Jonsmith9847/ROCO-224-BFA/MEDIA/first_design_1.PNG

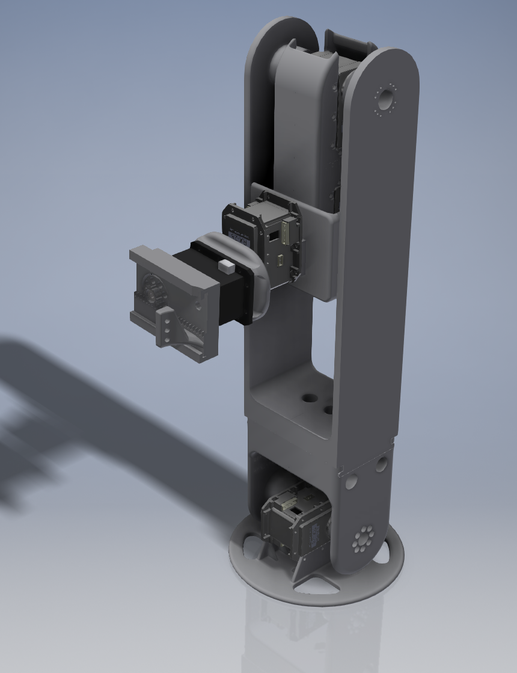
MEDIA/first_design_1.PNG
