Jonsmith9847/ROCO-224-BFA/MEDIA/IMG_20180423_183604.jpg

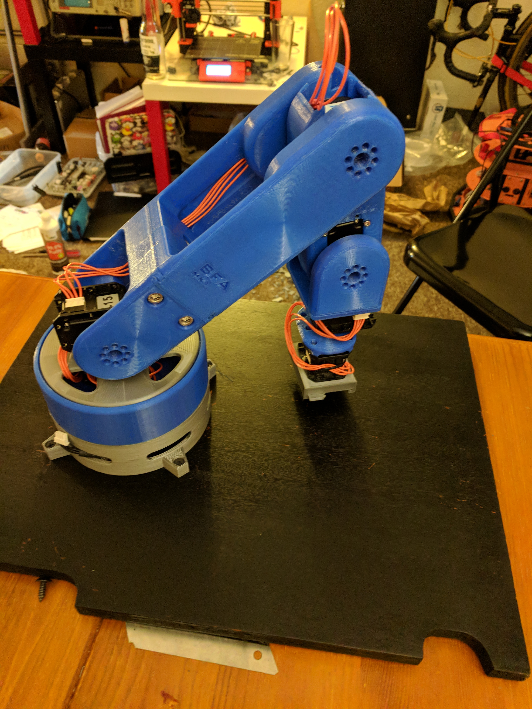
MEDIA/IMG_20180423_183604.jpg
