Jonsmith9847/ROCO-224-BFA/README.md

# ROCO-224 Robotic arm

## Group BFA - Teleoperated Space Manipulator
