Jonsmith9847/ROCO-224-BFA/CAD/ENS_SERVO-RX-28.pdf

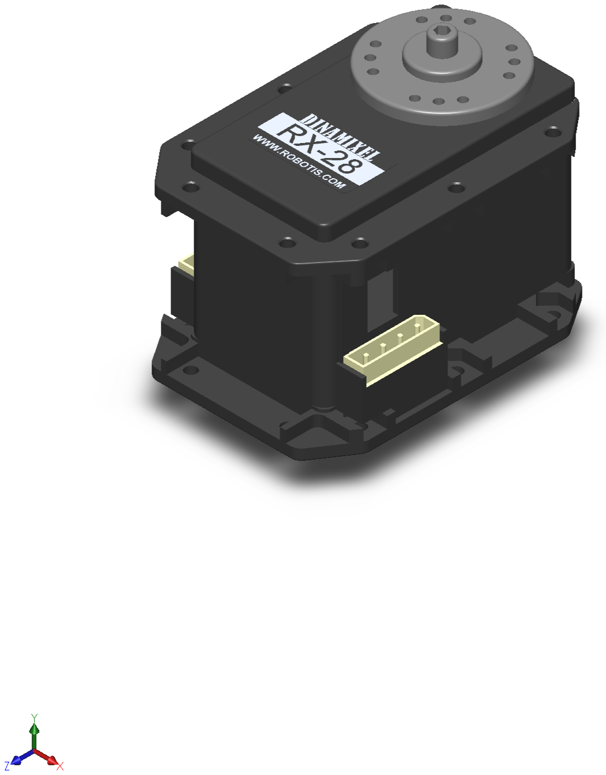
[picture p26: page 1]
