Jonsmith9847/ROCO-224-BFA/MEDIA/arm_assy_v2_render1.png

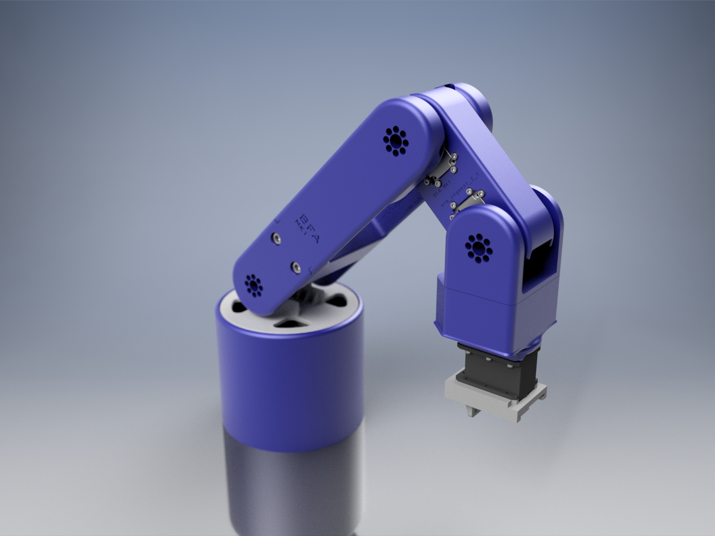
MEDIA/arm_assy_v2_render1.png
