Jonsmith9847/ROCO-224-BFA/MEDIA/arm_assy_v3_render1.png

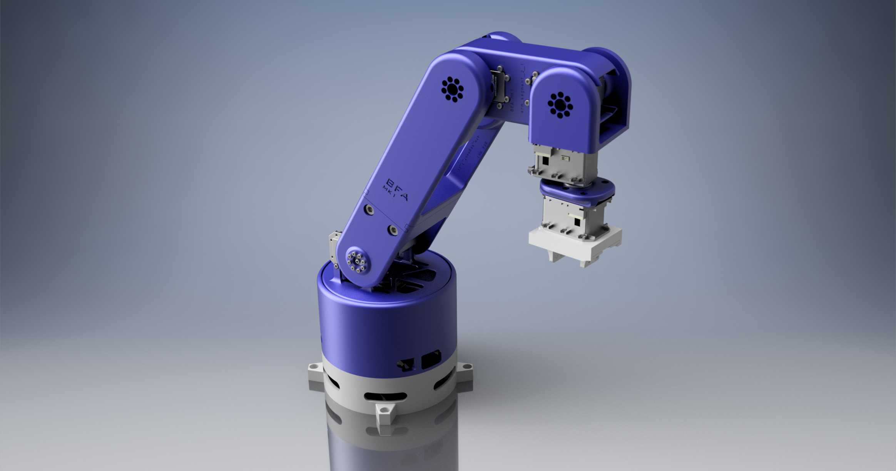
MEDIA/arm_assy_v3_render1.png
