Jonsmith9847/ROCO-224-BFA/MEDIA/base_turret_v2.png

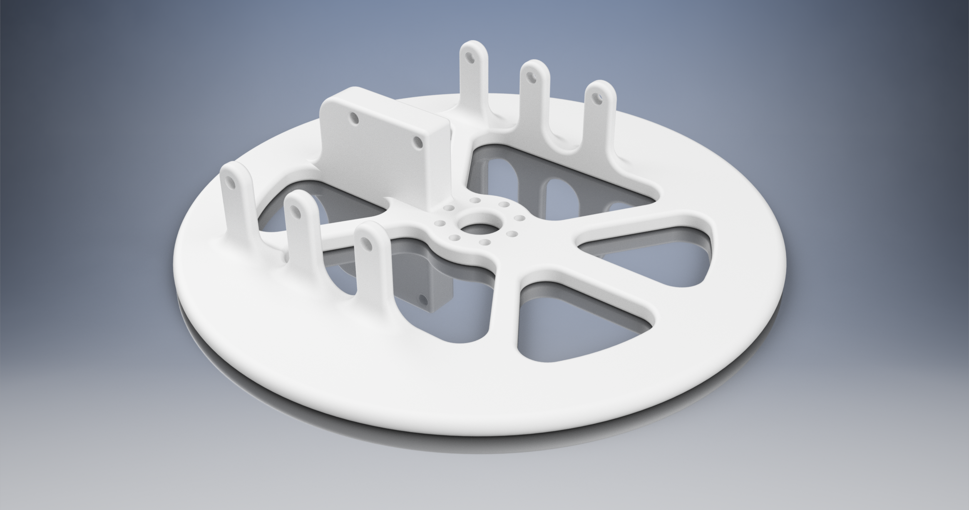
MEDIA/base_turret_v2.png
