Jonsmith9847/ROCO-224-BFA/MEDIA/IMG-20180423-WA0009.jpg

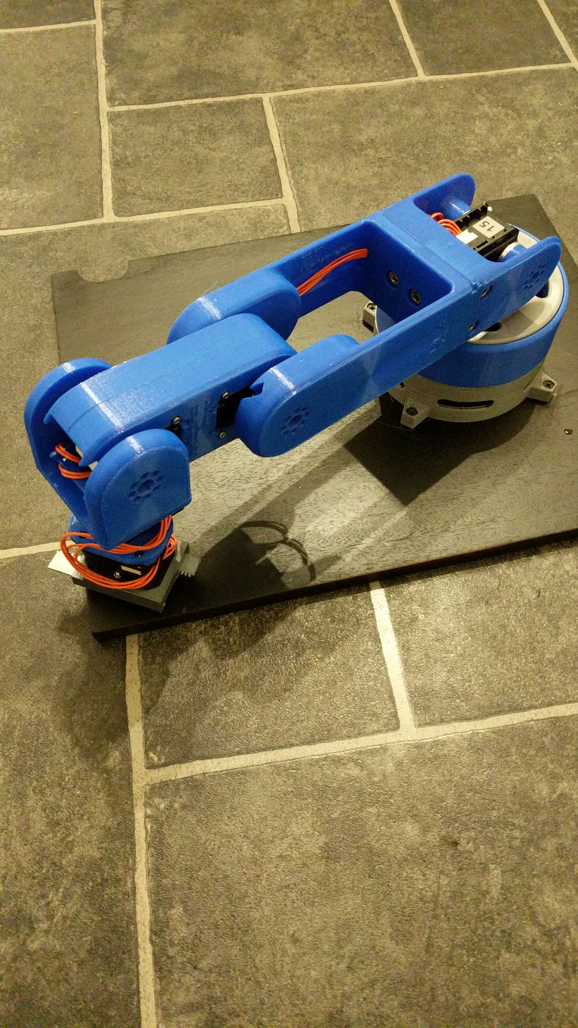
MEDIA/IMG-20180423-WA0009.jpg
