Jonsmith9847/ROCO-224-BFA/MEDIA/IMG_20180423_155627.jpg

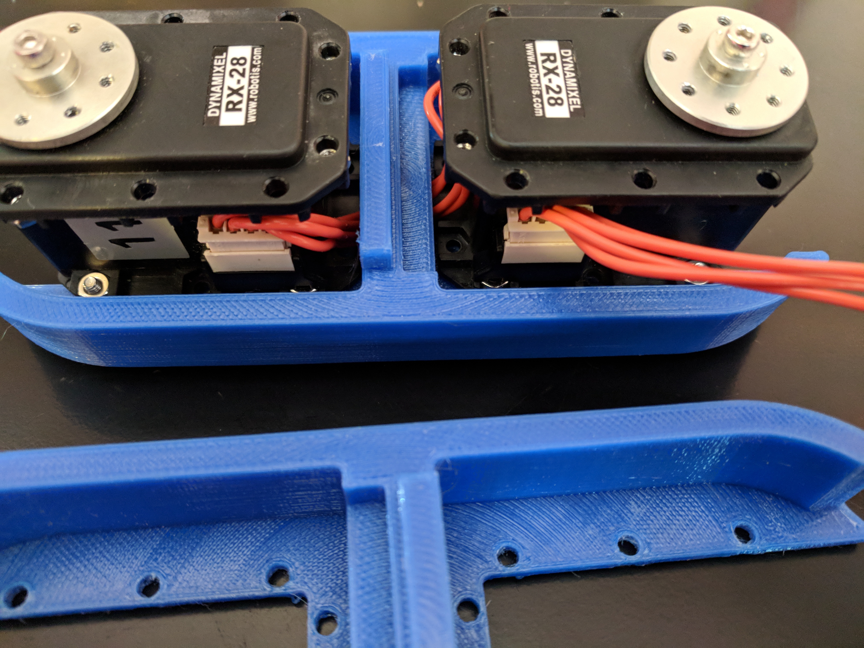
MEDIA/IMG_20180423_155627.jpg
