Jonsmith9847/ROCO-224-BFA/MEDIA/IMG_20180423_161050.jpg

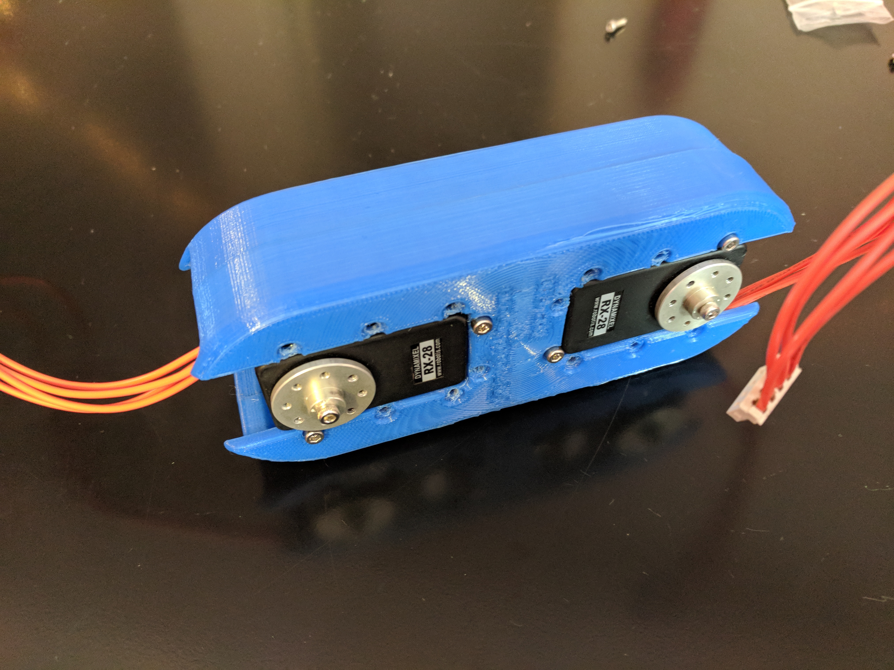
MEDIA/IMG_20180423_161050.jpg
