Jonsmith9847/ROCO-224-BFA/MEDIA/IMG_20180423_183607.jpg

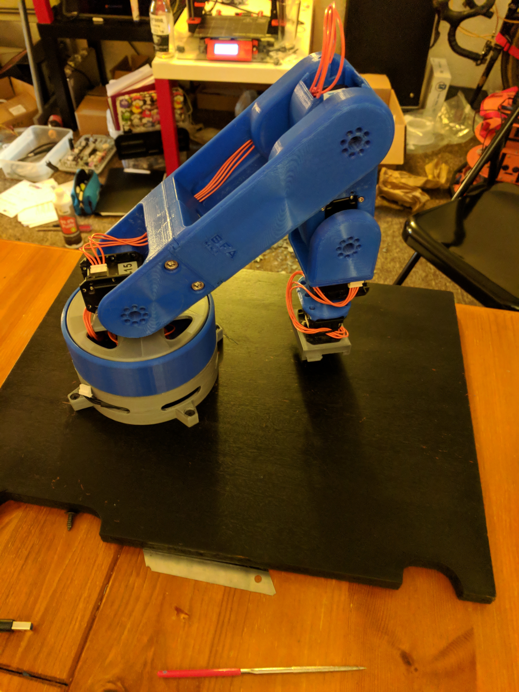
MEDIA/IMG_20180423_183607.jpg
