Jonsmith9847/ROCO-224-BFA/MEDIA/Screenshot from 2018-05-11 21-44-27.png

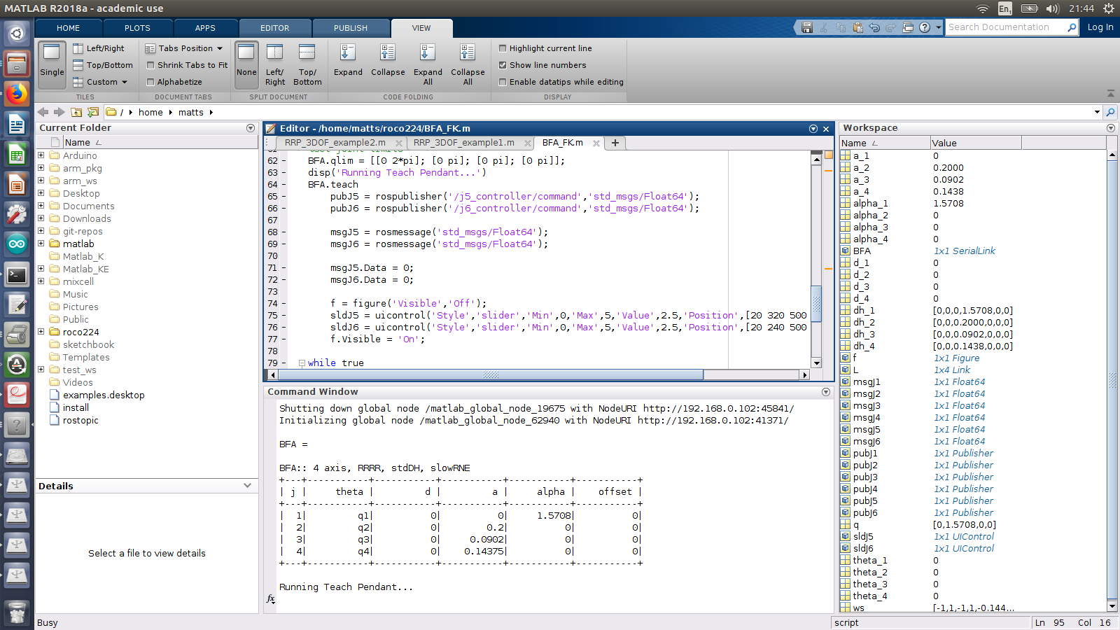
MEDIA/Screenshot from 2018-05-11 21-44-27.png
