Jonsmith9847/ROCO-224-BFA/CAD/Grabber_Assy.stp

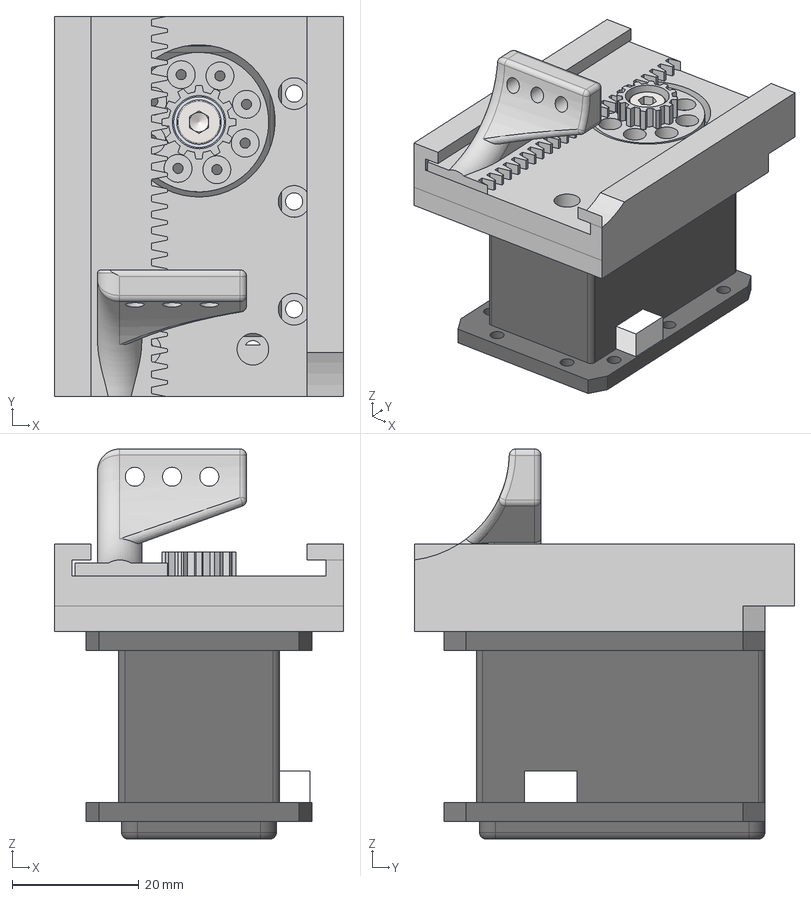
[picture p43: CAD file, 2018-05-16]
CAD/Grabber_Assy.stp
45.6 x 60.0 x 61.5 mm
Dynamixel__RX_28M
Horn_DynamixelServo
socket head cap screw_iso_ISO 4762 M4 x 6 --- 6N
