Jonsmith9847/ROCO-224-BFA/CAD/ENS_SERVO-RX-28.SLDASM

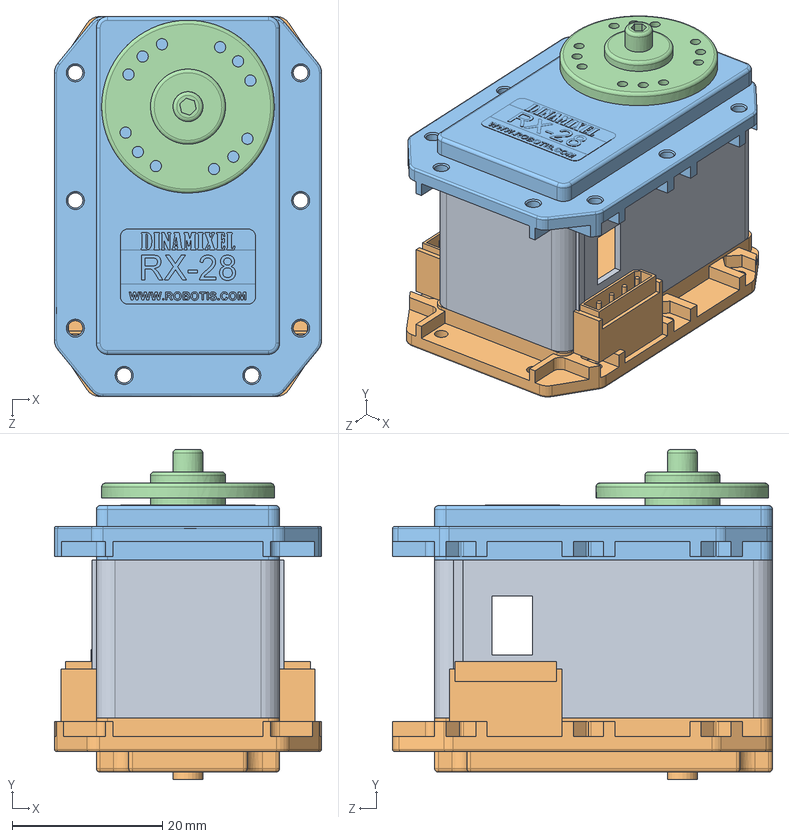
[picture p44: CAD file, 2018-05-16]
CAD/ENS_SERVO-RX-28.SLDASM
35.6 x 44.0 x 50.6 mm
Carcasa_RX-28
Tapa_Inf_RX-28
Tapa_Sup_RX-28
SOP-RX-28
