Jonsmith9847/ROCO-224-BFA/CAD/Grabber_Assy v3_Rack.stp

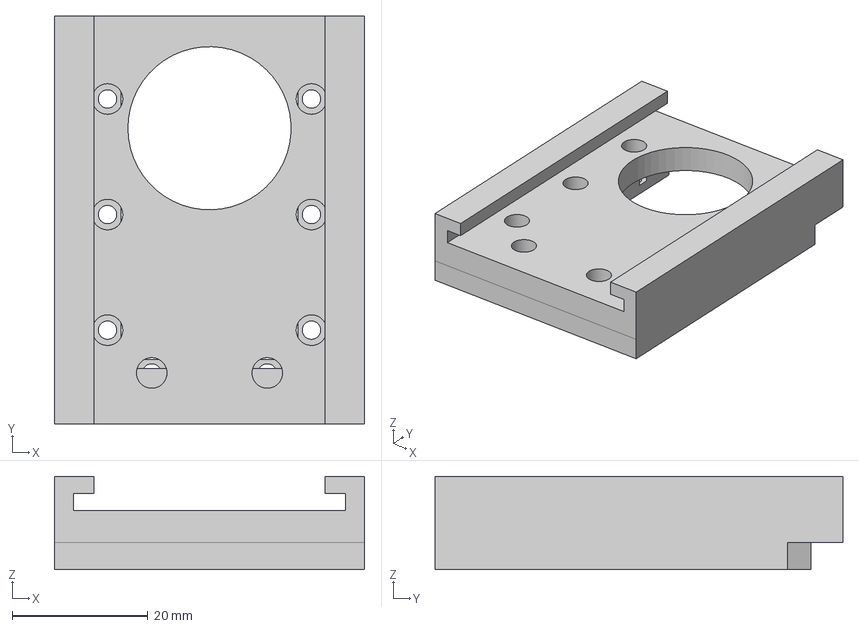
[picture p45: CAD file, 2018-05-16]
CAD/Grabber_Assy v3_Rack.stp
45.6 x 60.0 x 13.8 mm
