Jonsmith9847/ROCO-224-BFA/CAD/base_turret_v3.stl

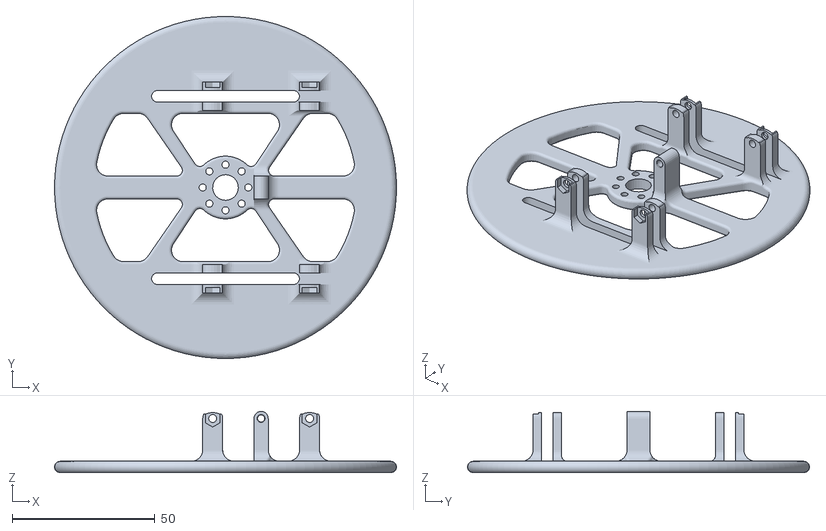
[picture p46: CAD file, 2018-05-16]
CAD/base_turret_v3.stl
120.0 x 120.0 x 21.5
