Jonsmith9847/ROCO-224-BFA/CAD/arm_segment_1_2c.stl

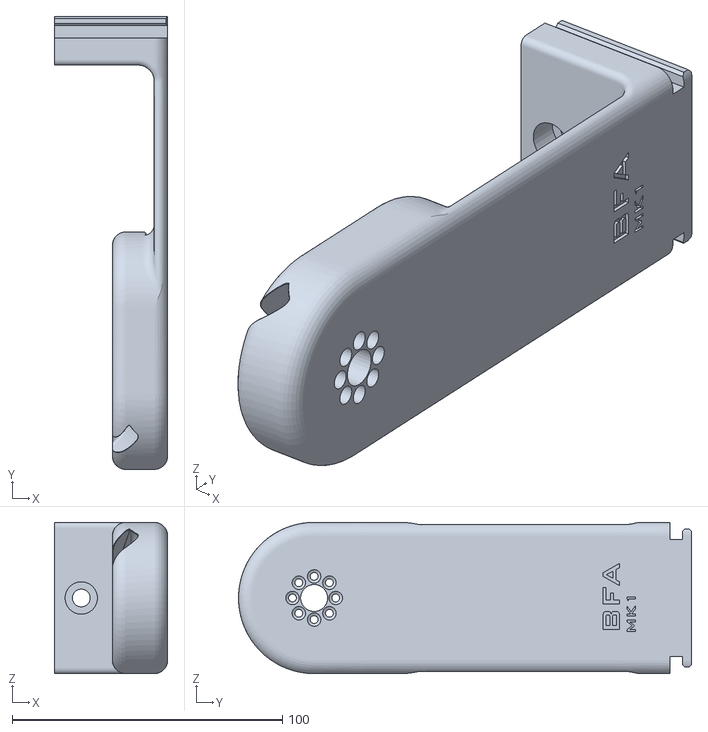
[picture p47: CAD file, 2018-05-16]
CAD/arm_segment_1_2c.stl
42.0 x 167.7 x 56.0
