Jonsmith9847/ROCO-224-BFA/CAD/rx28_mount_profile.dxf

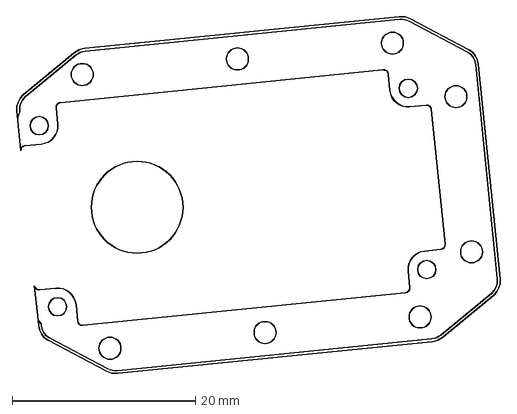
[picture p48: CAD file, 2018-05-16]
CAD/rx28_mount_profile.dxf
52.8 x 39.0 mm
