Jonsmith9847/ROCO-224-BFA/CAD/segment_1_horn_spacer.stl

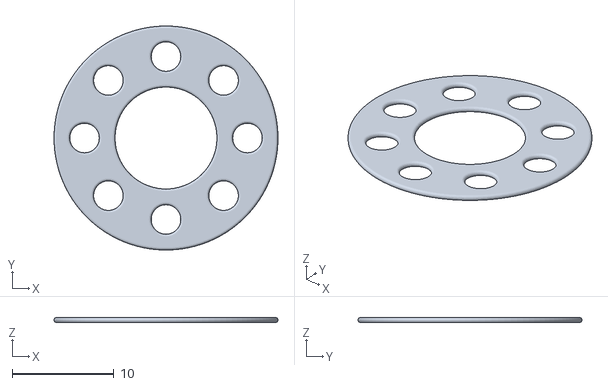
[picture p49: CAD file, 2018-05-16]
CAD/segment_1_horn_spacer.stl
22.0 x 22.0 x 0.5
