Jonsmith9847/ROCO-224-BFA/CAD/arm_segment_2_1.stl

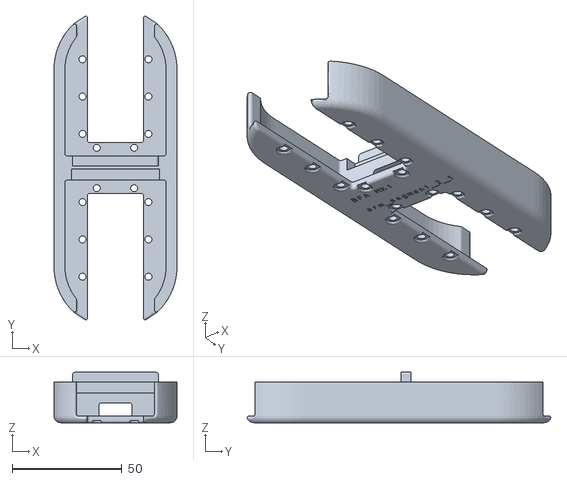
[picture p51: CAD file, 2018-05-16]
CAD/arm_segment_2_1.stl
56.0 x 138.3 x 23.0
