Jonsmith9847/ROCO-224-BFA/CAD/SOP-RX-28.SLDPRT

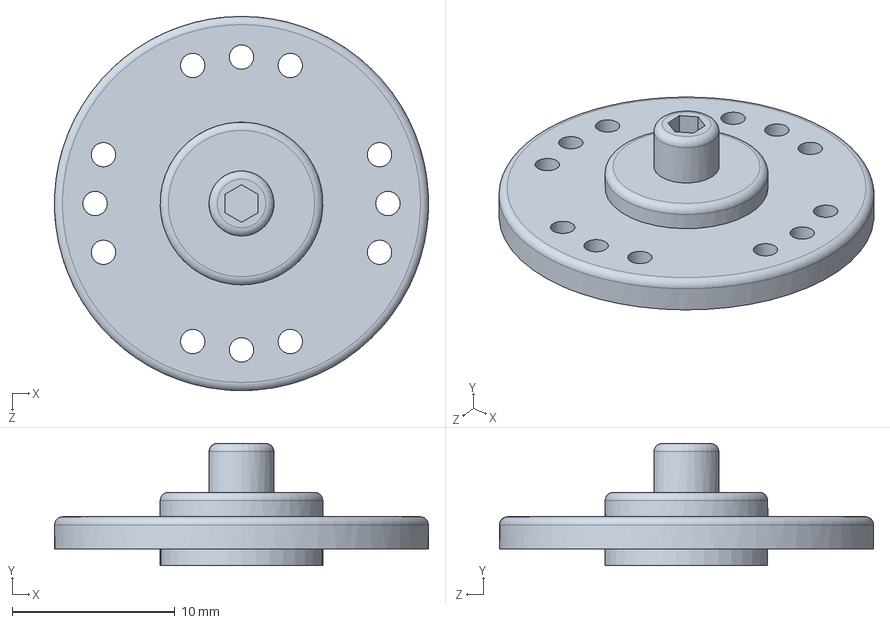
[picture p52: CAD file, 2018-05-16]
CAD/SOP-RX-28.SLDPRT
23.0 x 7.50 x 23.0 mm
