Jonsmith9847/ROCO-224-BFA/CAD/base_enclosure_2b.stl

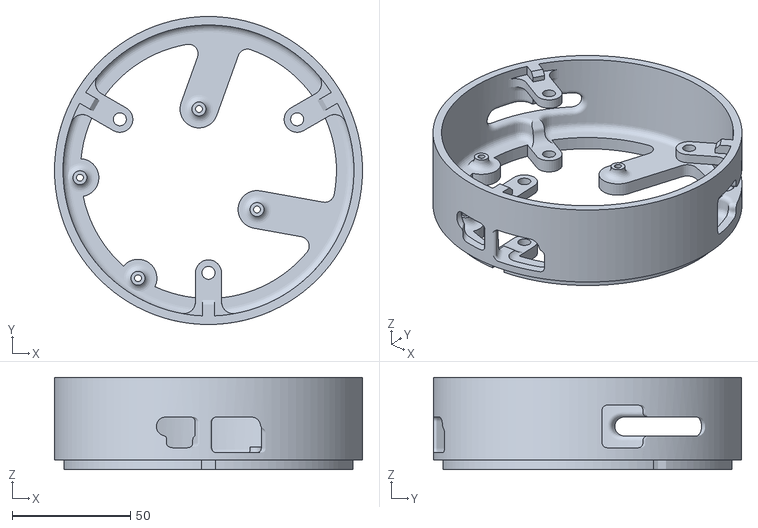
[picture p53: CAD file, 2018-05-16]
CAD/base_enclosure_2b.stl
130.0 x 130.0 x 39.0
