Jonsmith9847/ROCO-224-BFA/CAD/arm_segment_1_1b.stl

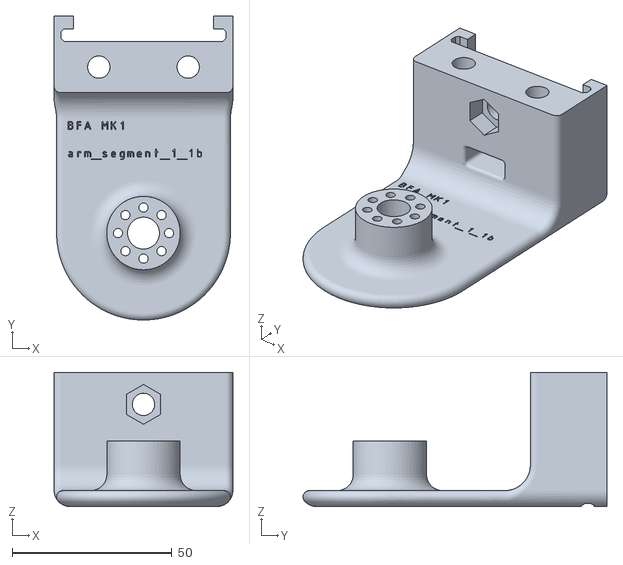
[picture p54: CAD file, 2018-05-16]
CAD/arm_segment_1_1b.stl
56.0 x 95.2 x 42.0
