Jonsmith9847/ROCO-224-BFA/CAD/arm_segment_1_1d.stl

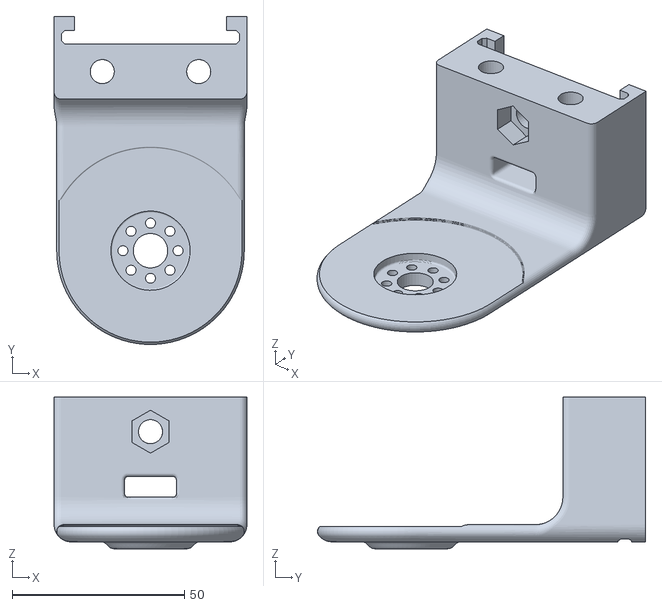
[picture p55: CAD file, 2018-05-16]
CAD/arm_segment_1_1d.stl
56.0 x 95.2 x 44.0
