Jonsmith9847/ROCO-224-BFA/CAD/arm_segment_3_2b.stl

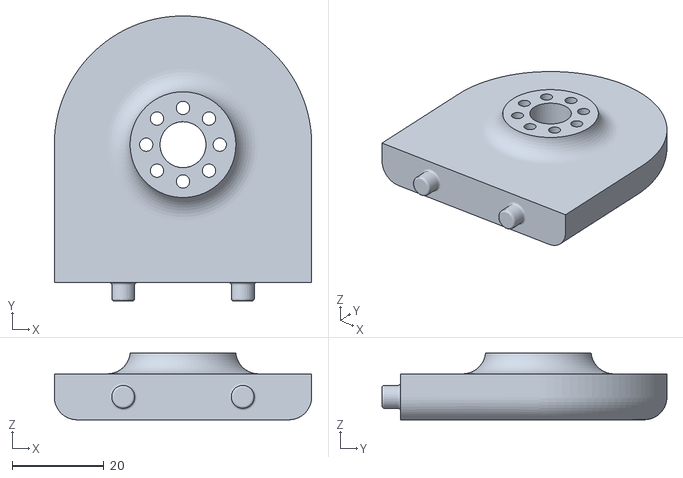
[picture p57: CAD file, 2018-05-16]
CAD/arm_segment_3_2b.stl
56.0 x 62.0 x 14.5
