Jonsmith9847/ROCO-224-BFA/CAD/arm_segment_3_2a_2.stl

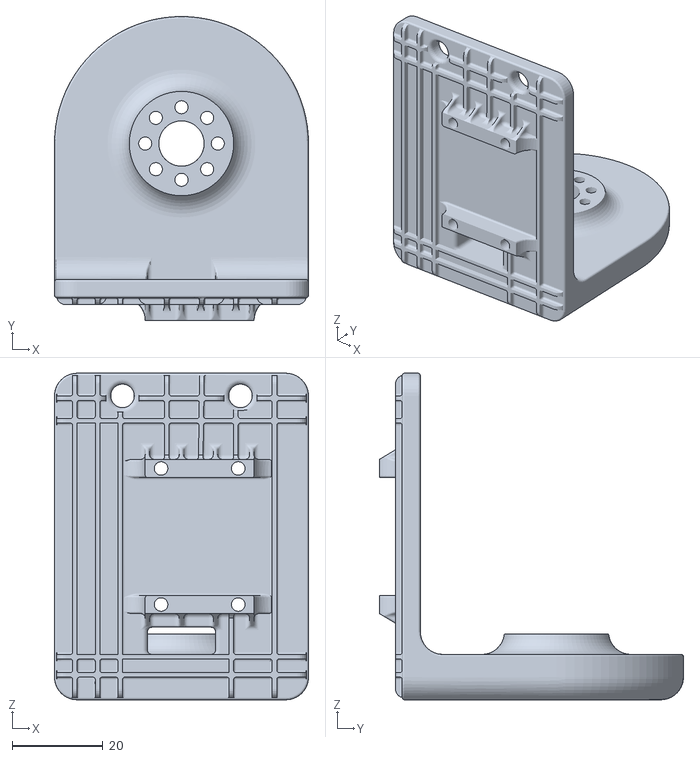
[picture p58: CAD file, 2018-05-16]
CAD/arm_segment_3_2a_2.stl
56.0 x 67.0 x 72.0
