Jonsmith9847/ROCO-224-BFA/CAD/dual_turret.stl

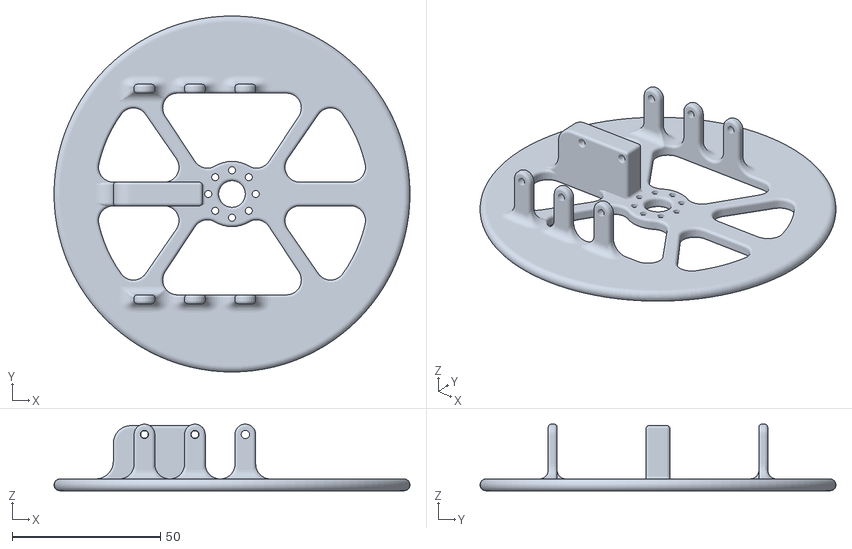
[picture p59: CAD file, 2018-05-16]
CAD/dual_turret.stl
120.0 x 120.0 x 22.5
