Jonsmith9847/ROCO-224-BFA/CAD/Carcasa_RX-28.SLDPRT

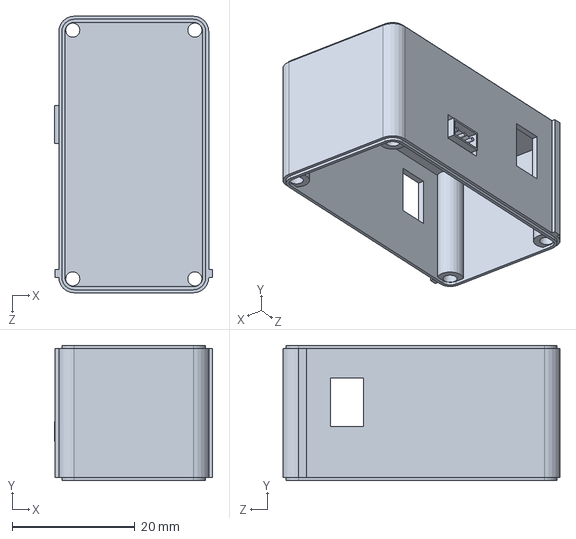
[picture p60: CAD file, 2018-05-16]
CAD/Carcasa_RX-28.SLDPRT
25.7 x 22.0 x 45.0 mm
