Jonsmith9847/ROCO-224-BFA/CAD/mech232_FEA_frame.stp

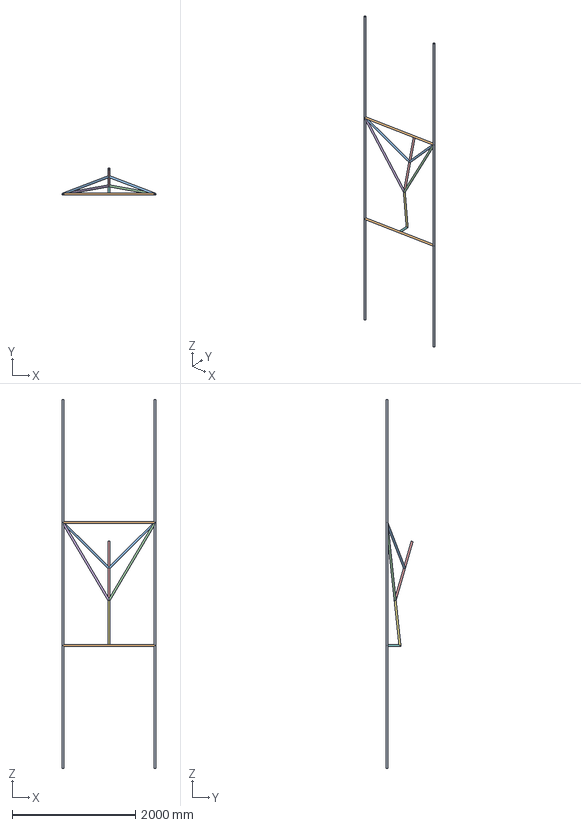
[picture p61: CAD file, 2018-05-16]
CAD/mech232_FEA_frame.stp
1533.7 x 444.0 x 6000.0 mm
mech232_skeleton
ISO 4200 - 33.7x3.2 - 2000
ISO 4200 - 33.7x3.2 - 2000_1
ISO 4200 - 33.7x3.2 - 1500
ISO 4200 - 33.7x3.2 - 1092.565
ISO 4200 - 33.7x3.2 - 1478.56806875
ISO 4200 - 33.7x3.2 - 2000_2
ISO 4200 - 33.7x3.2 - 1500_1
ISO 4200 - 33.7x3.2 - 2000_3
ISO 4200 - 33.7x3.2 - 2000_4
ISO 4200 - 33.7x3.2 - 2000_5
ISO 4200 - 33.7x3.2 - 1092.565_1
ISO 4200 - 33.7x3.2 - 1002.39999051
ISO 4200 - 33.7x3.2 - 1478.56806875_1
ISO 4200 - 33.7x3.2 - 754.79662029
ISO 4200 - 33.7x3.2 - 238.637
