Jonsmith9847/ROCO-224-BFA/CAD/arm_gopro_mount_1.stl

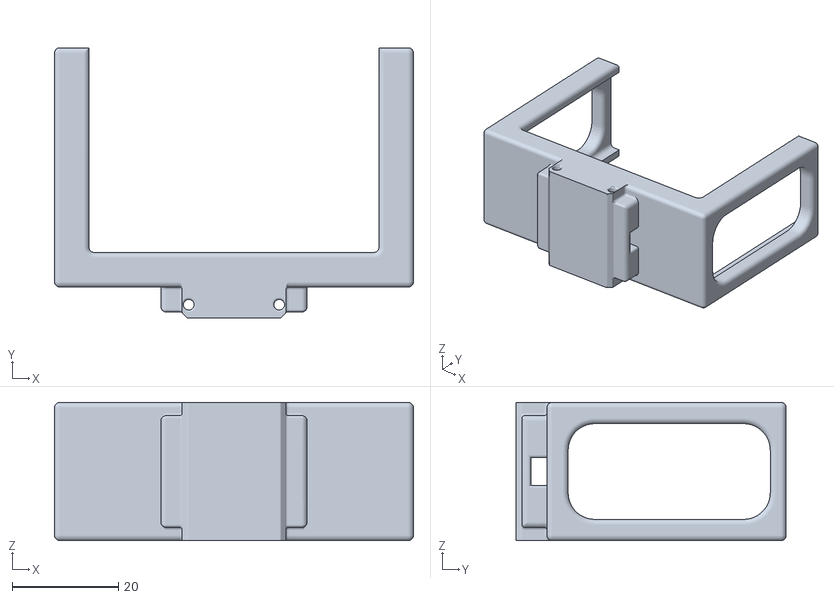
[picture p62: CAD file, 2018-05-16]
CAD/arm_gopro_mount_1.stl
67.5 x 50.8 x 26.0
