Jonsmith9847/ROCO-224-BFA/CAD/rx28_horn_profile2.dxf

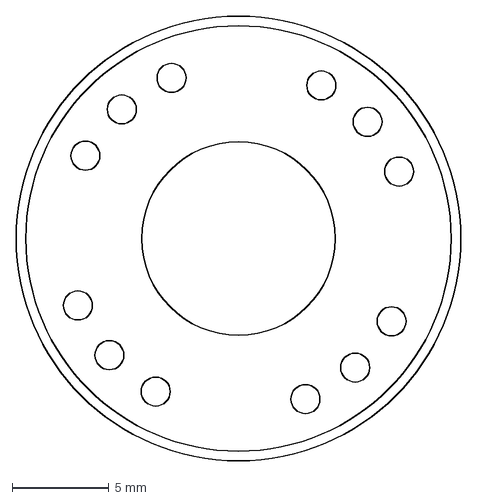
[picture p63: CAD file, 2018-05-16]
CAD/rx28_horn_profile2.dxf
23.0 x 23.0 mm
