Jonsmith9847/ROCO-224-BFA/CAD/dual_motor_spacer_1.stl

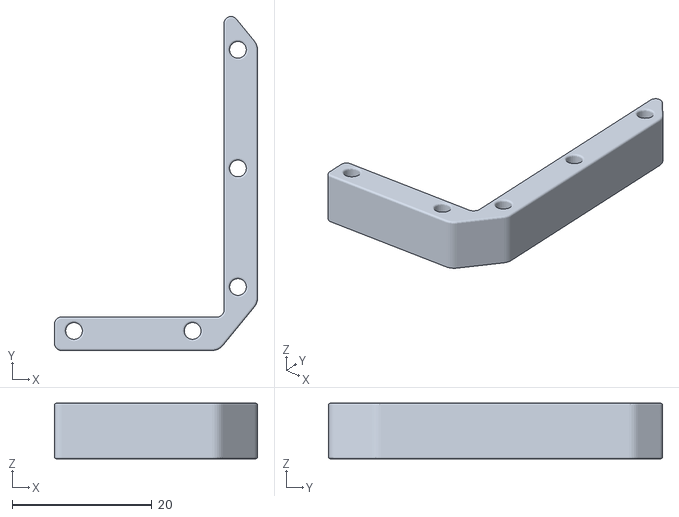
[picture p64: CAD file, 2018-05-16]
CAD/dual_motor_spacer_1.stl
29.1 x 47.9 x 8.00
