Jonsmith9847/ROCO-224-BFA/CAD/grabber_rotating_mount_1.stl

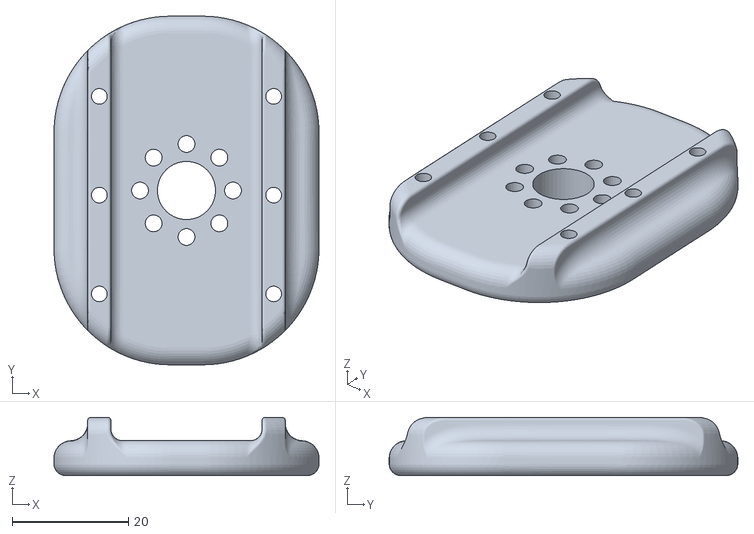
[picture p65: CAD file, 2018-05-16]
CAD/grabber_rotating_mount_1.stl
45.6 x 60.0 x 10.0
