Jonsmith9847/ROCO-224-BFA/CAD/base_enclosure_1.stp

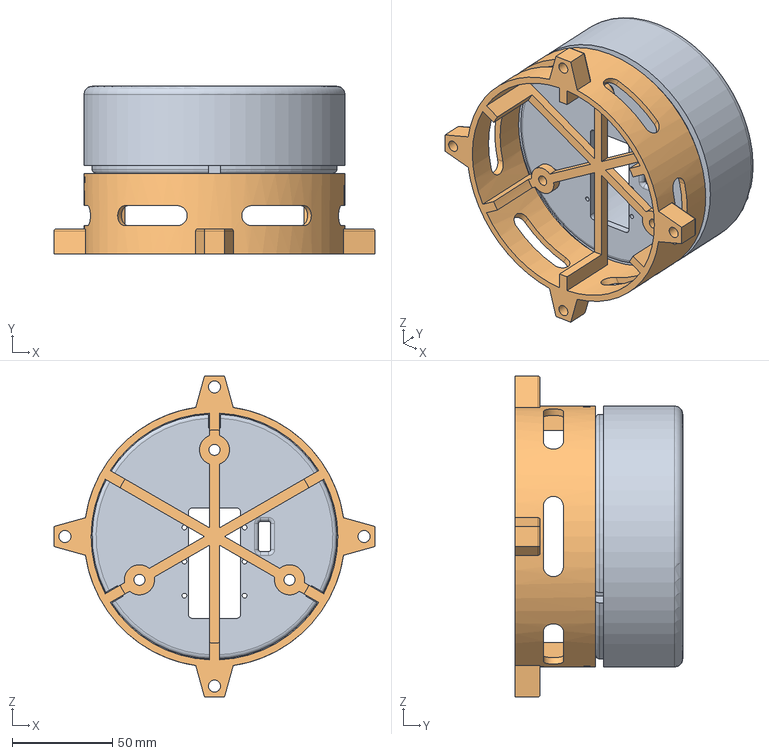
[picture p66: CAD file, 2018-05-16]
CAD/base_enclosure_1.stp
160.0 x 83.5 x 160.0 mm
