Jonsmith9847/ROCO-224-BFA/(list of files, cad)

Other CAD files:
CAD/arm_segment_1_1a.stl
CAD/arm_segment_1_1c.stl
CAD/base_enclosure_2.stl
CAD/Carcasa_RX-28.ipt
CAD/Component1.ipt
CAD/Component2.ipt
CAD/Component3.ipt
CAD/Dynamixel__RX_28M.ipt
CAD/ENS_SERVO-RX-28.iam
CAD/Grabber_Assy.iam
CAD/Horn_DynamixelServo.ipt
CAD/RX28 v1.iam
CAD/SOP-RX-28.ipt
CAD/arm_1_segment_v1.ipt
CAD/arm_assy_v1.iam
CAD/arm_assy_v2.iam
CAD/arm_assy_v3.iam
CAD/arm_gopro_mount_1.ipt
CAD/arm_segment_1_1a.ipt
CAD/arm_segment_1_1a2.ipt
CAD/arm_segment_1_1b.ipt
CAD/arm_segment_1_1b2.ipt
CAD/arm_segment_1_1c.ipt
CAD/arm_segment_1_1d.ipt
CAD/arm_segment_1_2a.ipt
CAD/arm_segment_1_2b.ipt
CAD/arm_segment_1_2c.ipt
CAD/arm_segment_2_1.ipt
CAD/arm_segment_3_1.ipt
CAD/arm_segment_3_2b.ipt
CAD/base_1.ipt
CAD/base_enclosure_1.ipt
CAD/base_enclosure_1.stl
CAD/base_enclosure_2.ipt
CAD/base_turret_v1.ipt
CAD/base_turret_v1.stl
CAD/base_turret_v2.ipt
CAD/base_turret_v2.stl
CAD/base_turret_v3.ipt
CAD/dual_motor_spacer_1.ipt
CAD/dual_motor_turret.iam
CAD/grabber_rotating_mount_1.ipt
CAD/mech232_FEA_frame.iam
CAD/mech232_FEA_frame_construction.ipt
CAD/mk1_GA.idw
CAD/segment_1_horn_spacer.ipt
CAD/socket head cap screw_iso_ISO 4762 M4 x 6 --- 6N.ipt
CAD/swivel_servo_cowl_1.ipt
